yukino1230/IV-Cord-Holder-for-HIOKI-3481/README.md

# HIOKI 3481 検電器用 IV線保持ジグ

日置電機（HIOKI）の非接触検電器 **3481** に取り付けて、先端のセンサー部（ノーズ）の横に IV 線を挟んで保持するための 3D プリント用ジグです。
検電器の先端を線に下から押し当てるだけでパチッとはまるので、機器に接続されたままの IV 線にも使えます。

**MakerWorld でも公開しています：** [HIOKI 3481 検電器用 IV線ホルダー](https://makerworld.com/ja/models/3461142-hioki-3481-voltage-detector-iv-wire-holder-iv-wire)（Bambu Studio のプリントプロファイル付き）

## 対応機種

| 機種 | 状態 |
|---|---|
| HIOKI 3481（LEDライト付き） | 動作確認済み |
| HIOKI 3480（LEDライトなし） | 対応見込み（未確認）。ジグが掛かる本体・リブ・ノーズの形状は 3481 と共通です |

3480 で使ってみた方は、Issue などで結果を教えてもらえるとうれしいです。

> **非公式品です。** 日置電機株式会社とは関係ありません。
> 使用前後に必ず既知の活線で検電器の動作を確認してください。使用は自己責任でお願いします（詳しくは[注意事項・免責](#注意事項免責)）。

| 取り付けた状態（ボタン面側） | 取り付けた状態（背面側） |
|---|---|
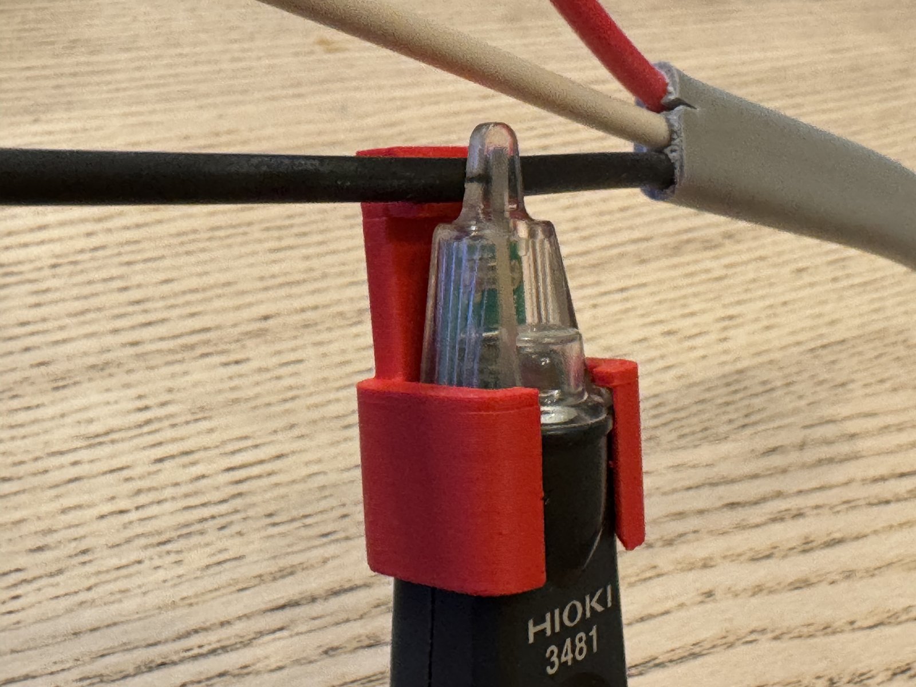
[picture p1: images/photo_in_use_front.jpg]
取り付けた状態・ボタン面側
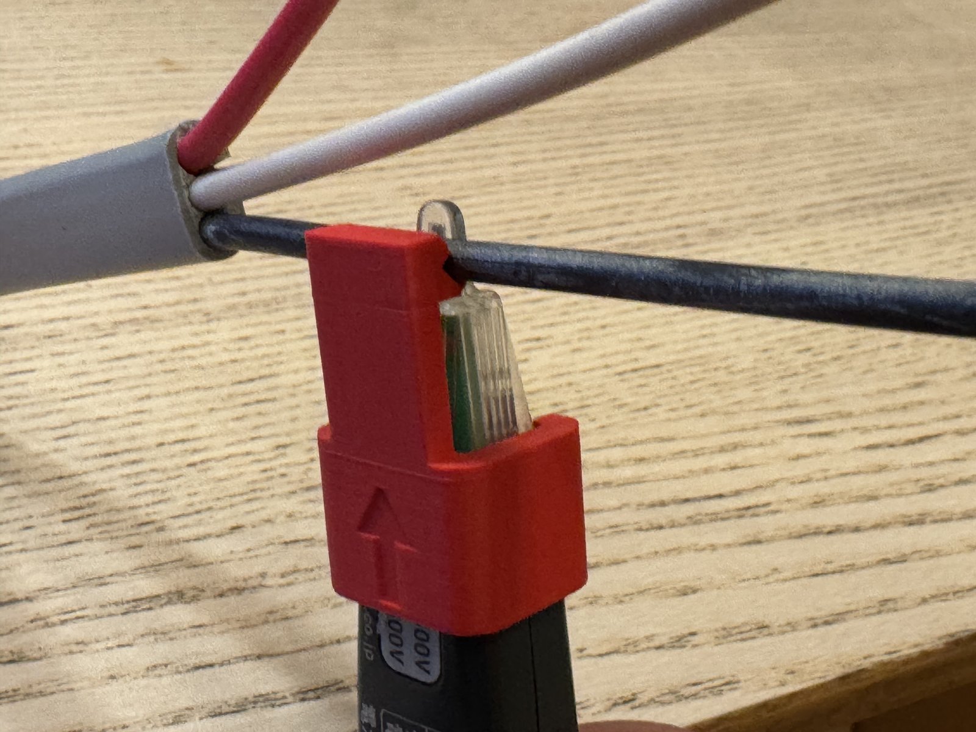
[picture p2: images/photo_in_use_back.jpg]
取り付けた状態・背面側
|  |  |

検電器に取り付けて IV 線を挟んだところ。線はノーズ（先端の平たいセンサー部）の側面に当たり、窓から ON/OFF ボタンと先端寄りの楕円部が見えます。

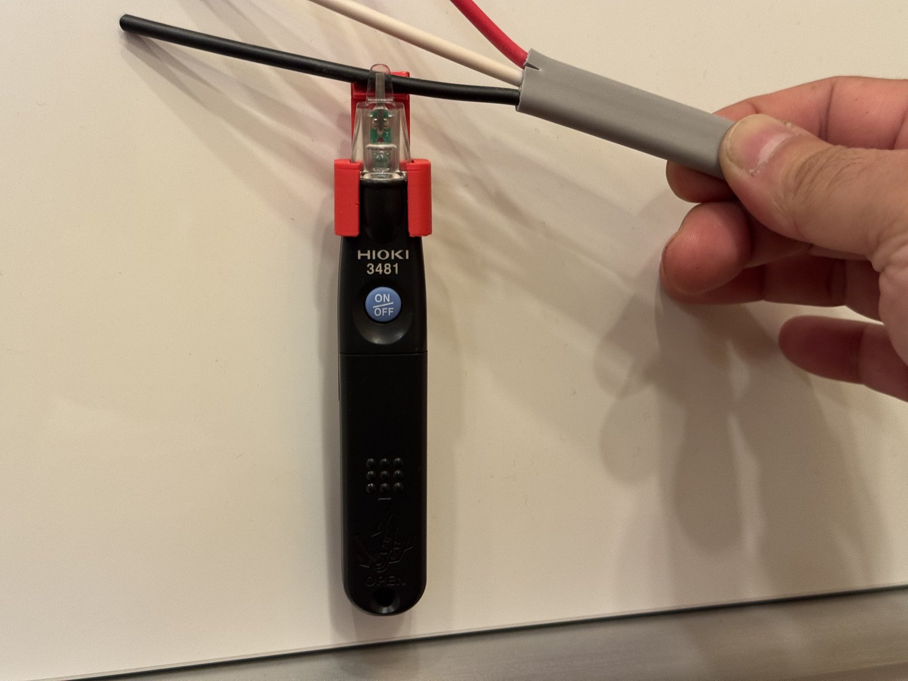
[picture p3: images/photo_hanging.jpg]
IV線にぶら下げた状態


IV 線にぶら下げた状態。一時的に手を離しても検電器ごと保持できますが、ぶら下げたまま放置しないでください。高所などで使うときは、検電器のストラップ穴に落下防止のストラップを付けてください。

| 単体（PLA で造形） | 3D モデル |
|---|---|
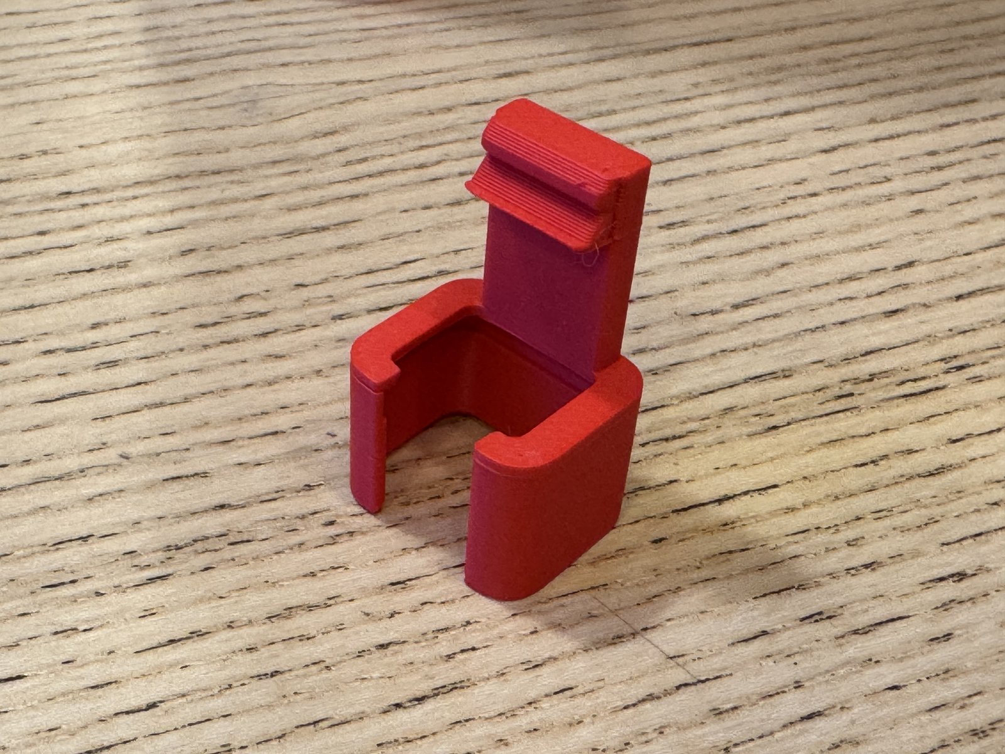
[picture p4: images/photo_printed.jpg]
実物
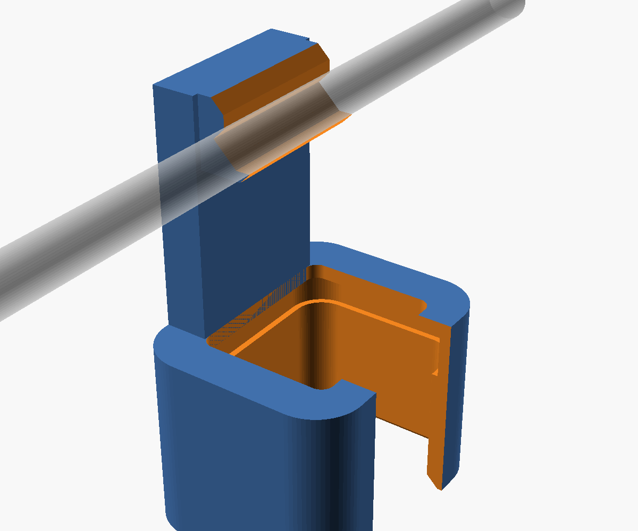
[picture p5: images/overview.png]
3Dモデル
|  |  |

## 特徴

- 検電器の先端ノーズ（平たい板状のセンサー部）の側面に、IV 線を軸と直交させて当てる
- **IV 1.6mm（外径 3.2mm）と IV 2.0mm（外径 3.4mm）の単線**に対応（V 溝で両方とも位置決め）
- 線がノーズを押す力で本体がスリーブの爪に押し付けられ、検電器と線の両方をしっかり保持
- スリーブのボタン面側は窓で開放しているので、ON/OFF ボタンと先端寄りの楕円部を覆わない
- アームの中に**結束バンドを補強材として埋め込める**ポケット付き（任意）

| IV 線の当たり方（線の方向から見た断面） | 結束バンドのポケット（アームの断面） |
|---|---|
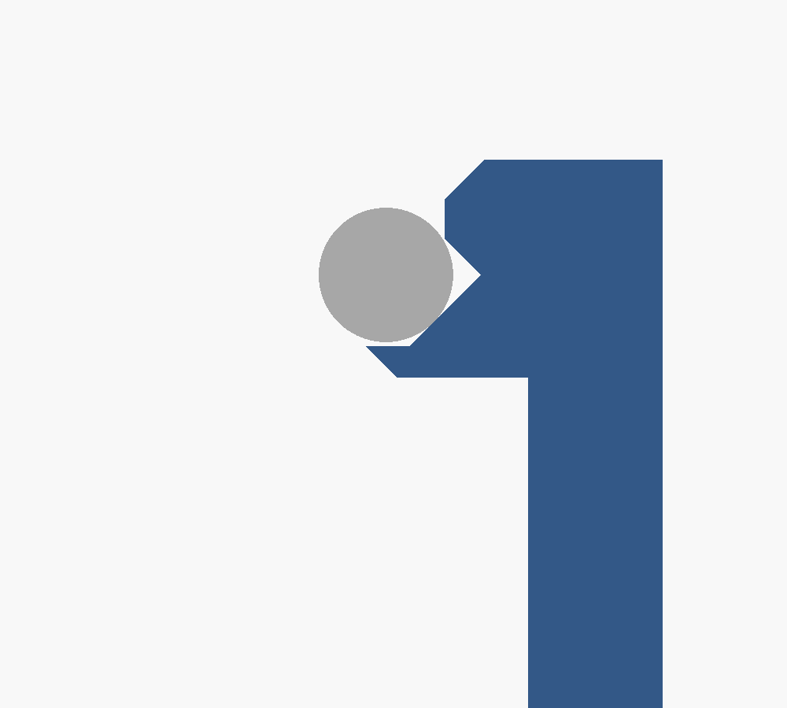
[picture p6: images/wire_contact.png]
線の当たり方
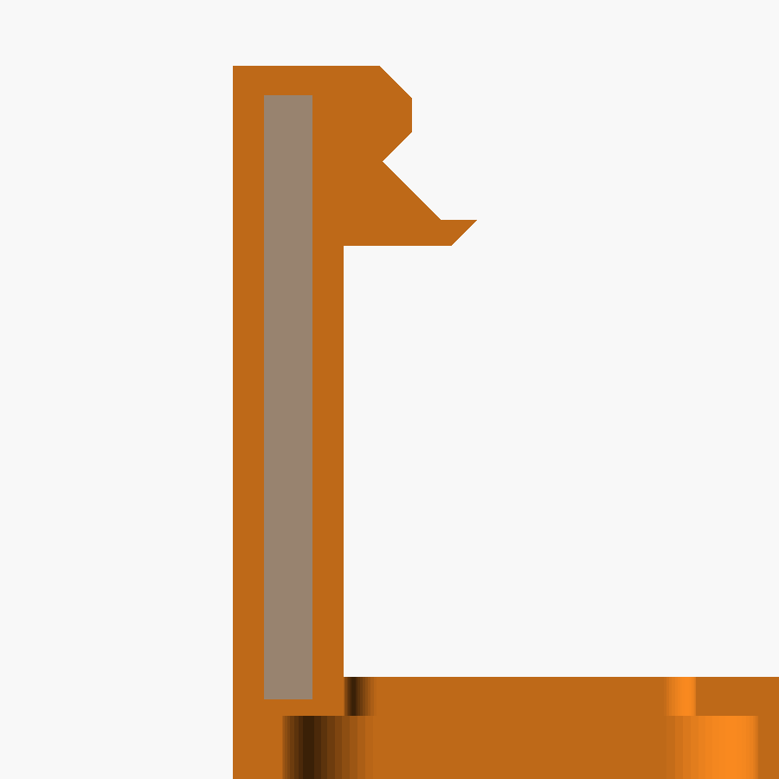
[picture p7: images/tie_pocket_section.png]
ポケット
|  |  |

## ファイル

| ファイル | 内容 |
|---|---|
| `hioki3481_iv_jig.scad` | OpenSCAD のソース（寸法はすべてパラメータで調整可） |
| `3mf/hioki3481_iv_jig_v17.2.3mf` | Bambu Studio 用のプロジェクト（ラフト・サポート・一時停止を設定済み） |
| `stl/hioki3481_iv_jig_v17.2.stl` | 結束バンドのポケット付き（おすすめ） |
| `stl/hioki3481_iv_jig_v17.2_no-tie.stl` | ポケットなし（補強材を入れない場合） |

## 印刷

- **向き：スリーブ（差し込み口）を下にして立てる。** 寝かせて刷ると、爪が開く方向の力が積層をまたぐので割れやすくなります。
- 材料：PLA で動作確認済み。PETG の場合は層間接着を優先（ノズル 240〜250℃、冷却ファン弱め）。
- 壁（ペリメーター）は 3 周以上がおすすめです。

### Bambu Studio 用の 3MF

`3mf/hioki3481_iv_jig_v17.2.3mf` には、下の「造形のポイント」の設定と、結束バンドを入れるための一時停止が入っています。

- プリンター：Bambu Lab P2S（0.4mm ノズル）、0.20mm Standard、PLA で作成
- ラフト 2 層、サポート有効（V 溝の下にサポートをペイント済み）、壁 3 周
- 一時停止：結束バンドのポケットにフタがかぶさる直前の層（ラフト込みで高さ 33.8mm の層の前）

ほかのプリンターで開く場合は、プリンターとフィラメントを自分の環境に切り替えてから、プレビューで一時停止の位置（ポケットがまだ開いている最後の層の次）を確認してください。

### 造形のポイント

- **ラフトを付ける**\
  立てて刷ると、ベッドに接するのはスリーブの細い縁だけで、背も高い（約 34mm）ため、途中で剥がれたり倒れたりしやすくなります。ラフトで接地面を広げると安定します。差し込み口の縁が潰れて広がる（エレファントフット）のも防げるので、検電器の差し込みもスムーズになります。
- **サポートを有効にし、「小さなオーバーハングを削除」はオフにする**\
  IV 線を受ける V 溝の下側（線が乗る受け面）が、アームから張り出した小さなオーバーハングになっています。「小さなオーバーハングを削除」がオンだと、ここのサポートが省かれて受け面が垂れ、線の位置や保持力が狂います。
- **結束バンドは、一時停止したらなるべく早く入れる**\
  待っている間に造形物が冷えると、再開後のフタの層がうまく接着しなかったり、ベッドから角が浮いたりします。PETG ではノズルから樹脂が垂れやすいので、再開前にノズル先端の垂れを取っておくと、フタがきれいに閉じます。

### 結束バンドの埋め込み（ポケット付きの場合）

補強材として、ヘラマンタイトン AB300（幅 4.9 × 厚 1.5mm）相当の結束バンドを使います。ナイロンなので絶縁物で、検電の感度に影響しません。

1. 結束バンドの平らな部分を **17〜18mm** に切る（ポケットの長さは約 18.7mm。長すぎなければ、短いぶんには問題なし）。
2. Bambu Studio のプレビューで、**ポケットにフタがかぶさる最初の層**に一時停止を入れる。
   レイヤースライダーの上の「+」を右クリック →「一時停止を追加」。
   モデル単体での高さは約 33.2〜33.4mm ですが、**ラフトを付けるとその厚みの分だけ高くなる**ので、高さの数字ではなく、プレビューでポケットがまだ開いている最後の層を確かめて、その次の層に入れてください。
3. 止まったらすぐに結束バンドをポケットに押し込み、上端が縁から出ていないことを確認して再開する。

ポケットの高さや切る長さは、OpenSCAD でレンダリングしたときのコンソール（ECHO）にも表示されます。

## 使い方

1. 検電器の先端を、**スリーブの後ろ（面取りしてある口）から差し込み**、先端のツバに当たるまで押し込む。
   背中の矢印が差し込む向きです。
   **ボタン面側から横に押し込むと爪が割れます。**
2. 検電器の先端を上に向け、IV 線に下から押し当てて、ノーズの横の V 溝にはめる（爪を越えてパチッと入る）。
3. 検電する。
4. 外すときは、検電器を下へ引いて線を V 溝から外してから、検電器をスリーブの後ろへ抜く。

| 差し込み口（スリーブの後ろ） | 背面の矢印（差し込む向き） | 取り付けた状態 |
|---|---|---|
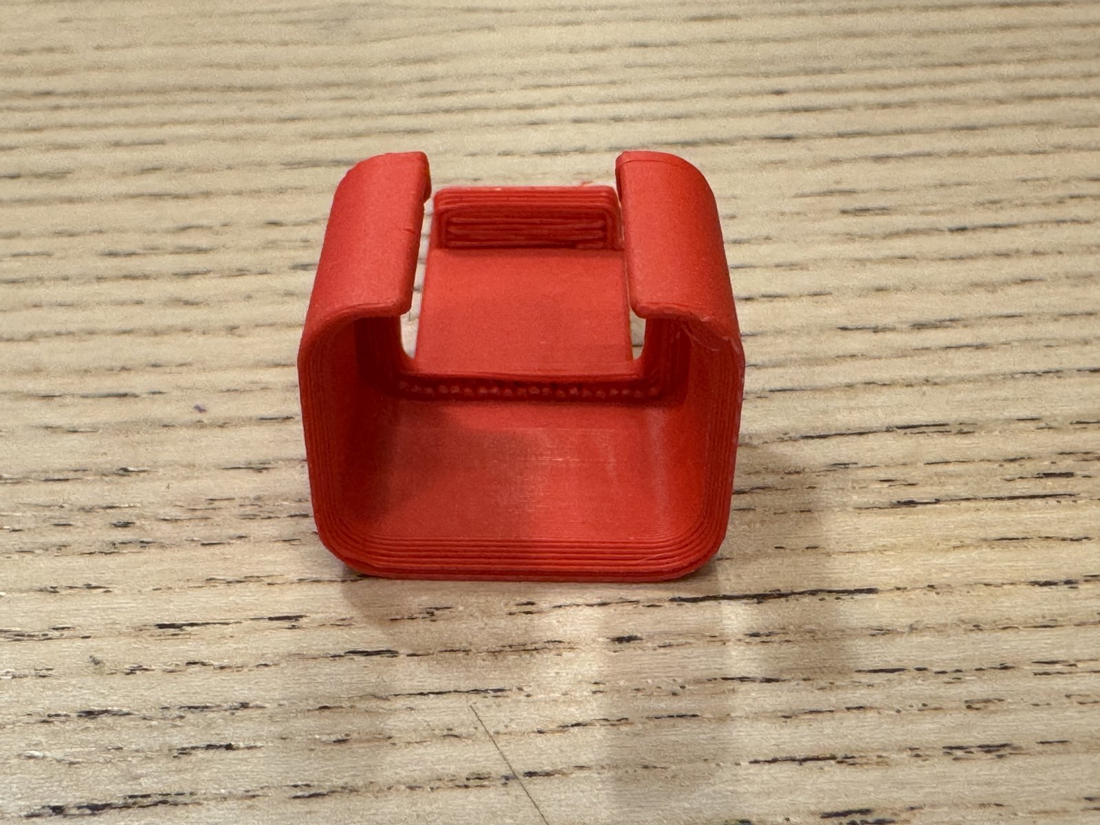
[picture p8: images/photo_rear_opening.jpg]
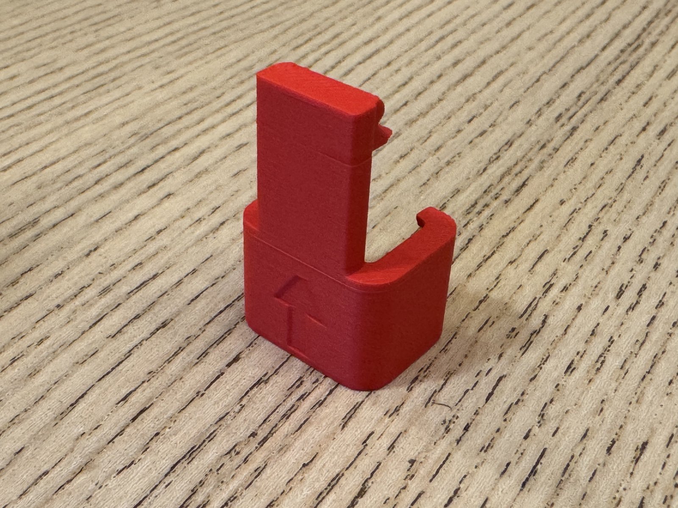
[picture p9: images/photo_printed_back.jpg]
背面の矢印
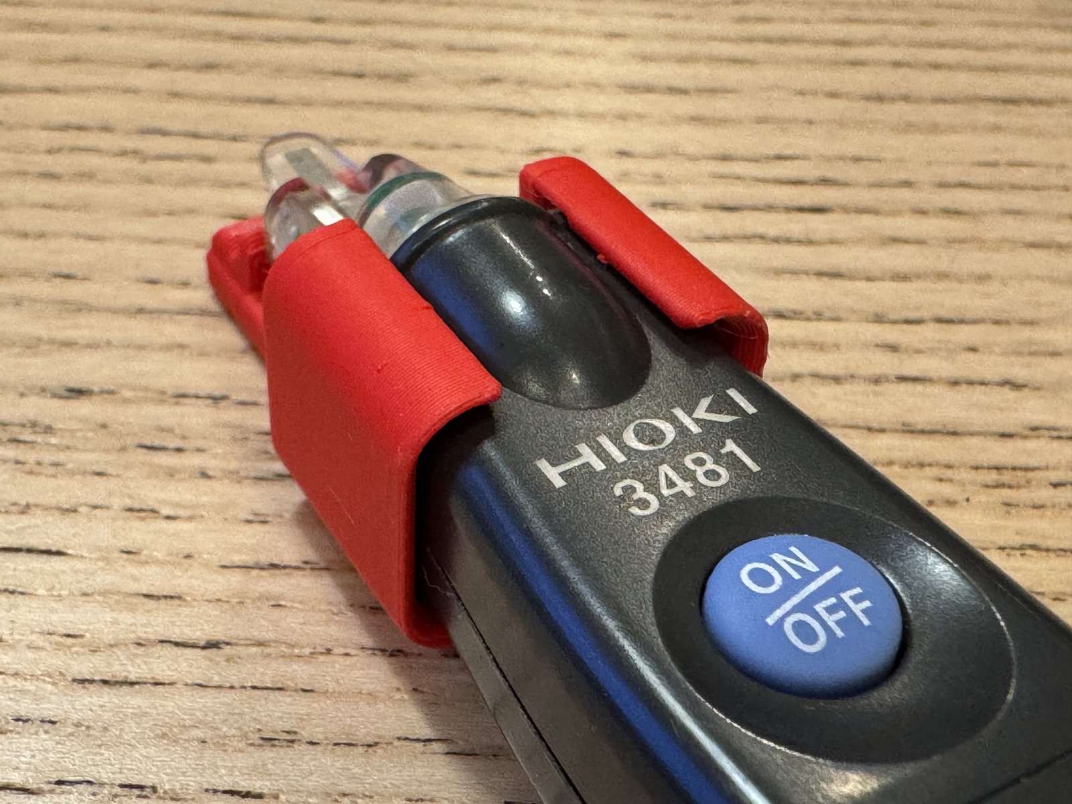
[picture p10: images/photo_attached.jpg]
取り付けた状態
|  |  |  |

取り付けると、窓から ON/OFF ボタンと先端寄りの楕円部が見えたままになり、ボタンもそのまま押せます。

<details>
<summary>3D モデルの図（差し込み口・背面の矢印）</summary>

| 差し込み口（3D モデル） | 背面の矢印（3D モデル） |
|---|---|
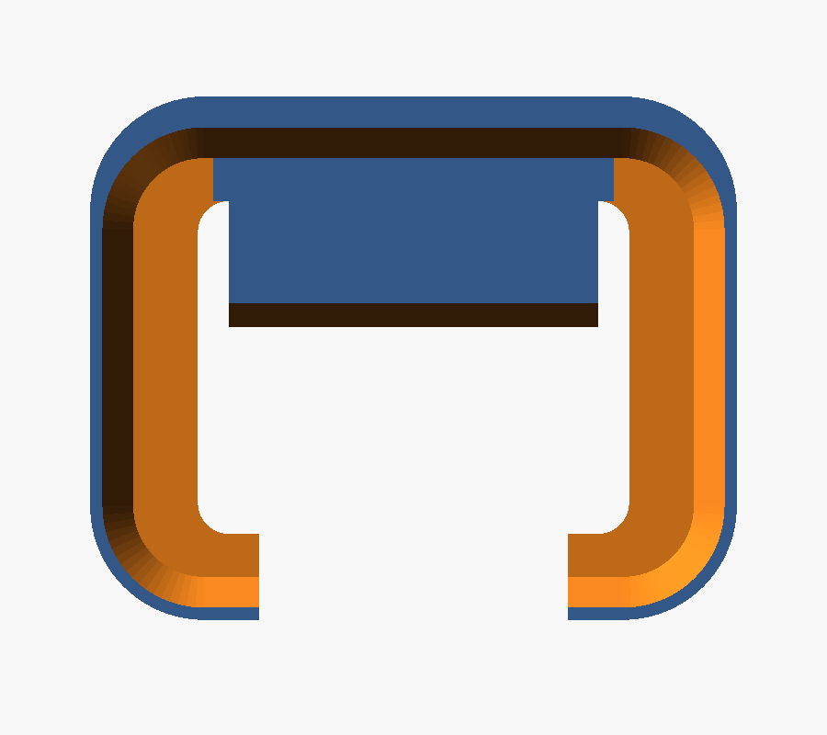
[picture p11: images/rear_opening.png]
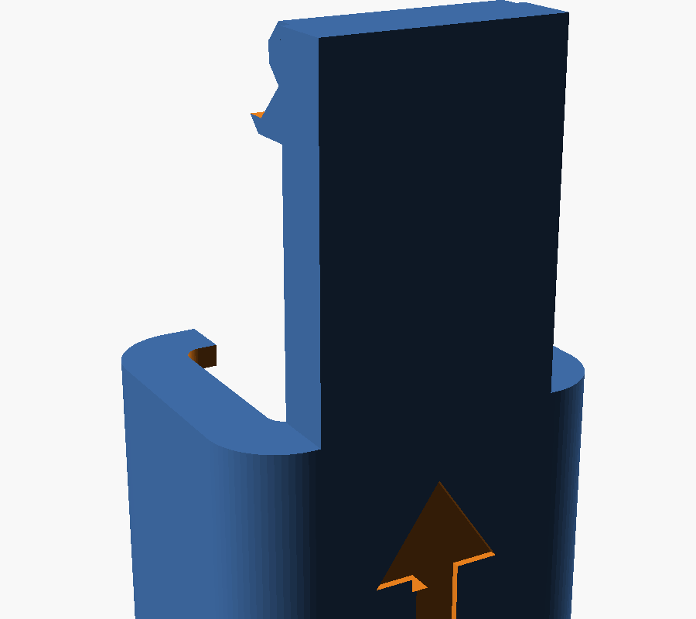
[picture p12: images/back_arrow.png]
矢印
|  |  |

</details>

## 調整できる主なパラメータ

| パラメータ | 初期値 | 内容 |
|---|---|---|
| `clr_d` | 0.3 | 厚み方向の片側すき間。増やすと V 溝も同じだけ自動でずれ、線の押し付け量は変わらない |
| `w_extra` | 0.6 | 幅方向に追加する余裕（合計） |
| `squeeze` | 0.15 | IV 1.6mm をノーズへ押し付ける量（IV 2.0mm はこれ + 約 0.25mm） |
| `open_gap` | 2.8 | V 溝の入口の幅。線を押し込むのが固ければ 3.0 前後に |
| `use_rib` | true | false で結束バンドのポケットなし |
| `tie_w` / `tie_t` | 4.9 / 1.5 | 結束バンドの幅・厚み |
| `tie_clr` | 0.03 | ポケットの片側すき間。入らなければ 0.05〜0.08 に |
| `rib_ch` | 1.0 | リブ受け溝の後ろ側の段差を斜めにする長さ。外すのが硬ければ増やす（0 で段差のまま） |
| `contact_h` | 5.0 | ノーズ頂点から IV 線の中心までの距離（当てる高さ） |

本体寸法は実機の実測値と、日置電機が公開している外形図（3481A040）を参考にしています。外形図そのものはこのリポジトリには含めていません。

## 注意事項・免責

- 本品は個人が製作した非公式のデータです。日置電機株式会社とは関係ありません。
- 保持力は、使用するプリンター・材料・印刷設定・線の状態によって変わります。使用前に、保持力と検電器の動作を必ず確認してください。
- 線にぶら下げたまま放置しないでください。高所や、落下すると物を傷つけるおそれのある場所では、検電器のストラップ穴に落下防止のストラップを付けて使用してください。
- 爪やアームにヒビ・白化が見られたら使用をやめてください。
- 本データの使用によって生じた検電器の落下・破損、建物や設備の損傷、事故その他いかなる損害についても、作者は責任を負いません。すべて使用者の責任でご利用ください。

## バージョン

現在の版：**v17.2**　変更履歴は [CHANGELOG.md](CHANGELOG.md) を参照。

## ライセンス

[CC BY-NC 4.0](https://creativecommons.org/licenses/by-nc/4.0/deed.ja)（表示 - 非営利）。詳しくは [LICENSE](LICENSE) を参照。
改変・再配布は自由ですが、作者の表示が必要で、営利目的での利用（販売など）はできません。

---

### English summary

A 3D-printable jig for the HIOKI 3481 non-contact voltage detector (the 3480 shares the same body shape and should also fit, but is untested) that holds a solid IV wire (1.6 mm / 2.0 mm) against the side of the detector's sensor tip. Print standing (sleeve opening down). Optional pocket for a nylon cable tie (4.9 × 1.5 mm) as an insulating stiffener, inserted during a print pause. Insert the detector from the rear of the sleeve only. Unofficial; not affiliated with HIOKI E.E. Corporation. Always verify the detector on a known live circuit before and after use. Do not leave the detector hanging on the wire unattended; use a lanyard on the detector's strap hole when working at height. Provided as-is without warranty; the author accepts no liability for any damage, including a dropped or damaged detector or damage to buildings or equipment. Use at your own risk. Licensed under CC BY-NC 4.0. Also on MakerWorld: https://makerworld.com/ja/models/3461142-hioki-3481-voltage-detector-iv-wire-holder-iv-wire
