yukino1230/IV-Cord-Holder-for-HIOKI-3481/3mf/hioki3481_iv_jig_v17.2.3mf

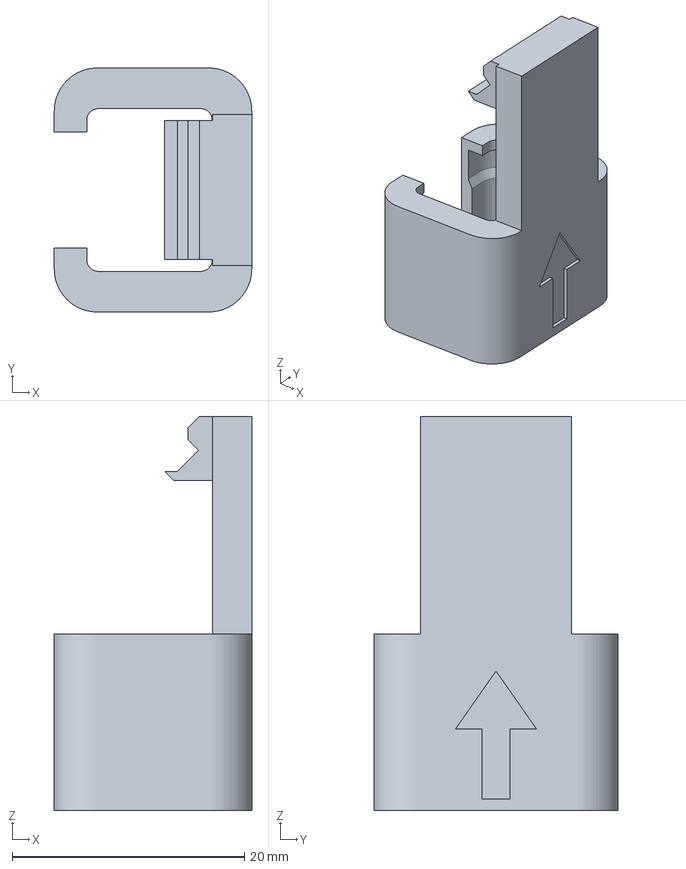
[picture p13: CAD file, 2026-10-11]
3mf/hioki3481_iv_jig_v17.2.3mf
17.0 x 21.0 x 33.9 mm
