yukino1230/IV-Cord-Holder-for-HIOKI-3481/stl/hioki3481_iv_jig_v17.2_no-tie.stl

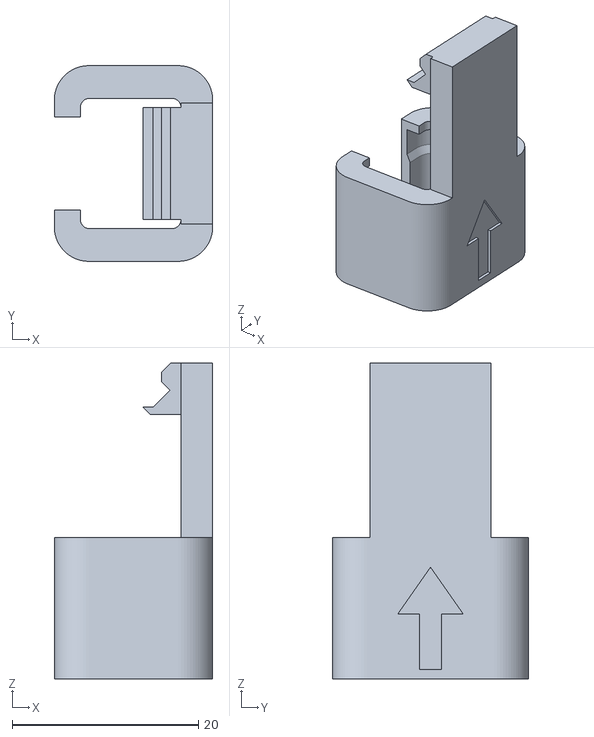
[picture p14: CAD file, 2026-10-11]
stl/hioki3481_iv_jig_v17.2_no-tie.stl
17.0 x 21.0 x 33.9
