yukino1230/IV-Cord-Holder-for-HIOKI-3481/stl/hioki3481_iv_jig_v17.1.stl

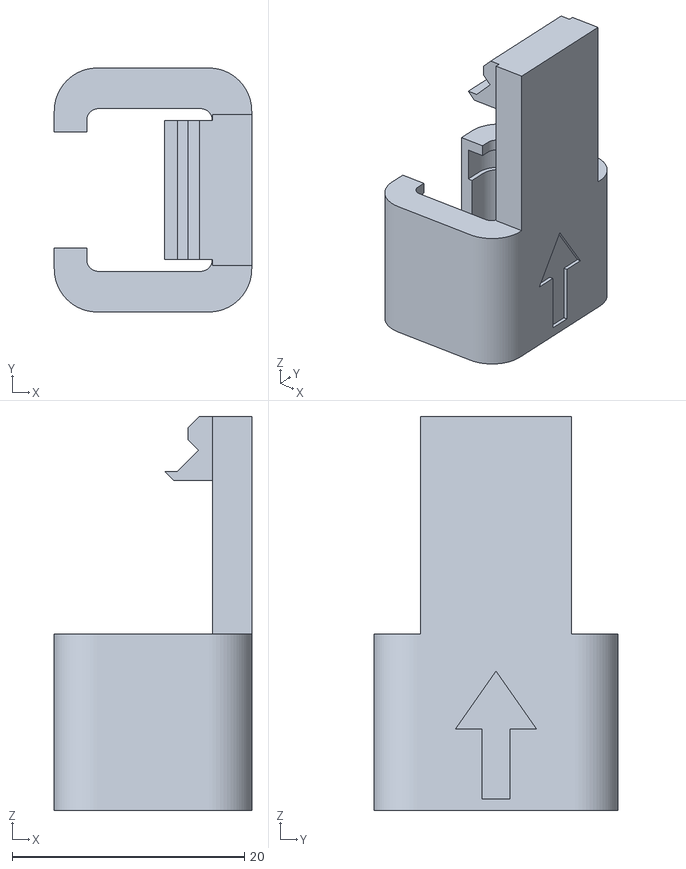
[picture p15: CAD file, 2026-10-11, an earlier design]
stl/hioki3481_iv_jig_v17.1.stl
17.0 x 21.0 x 33.9
