yukino1230/IV-Cord-Holder-for-HIOKI-3481/(list of files, cad)

Other CAD files:
stl/hioki3481_iv_jig_v17.2.stl
