yukino1230/IV-Cord-Holder-for-HIOKI-3481/CHANGELOG.md

# 変更履歴

試作と現物合わせで形を詰めてきた経緯です。

## v17.2
- リブ受け溝の後ろ側の直角の段差を、1.0mm かけて斜めにした（`rib_ch`）。検電器を外すときにリブが乗り上げやすくなり、外すのが楽になった。
- 線をはめていない状態では前後に少しカタつくが、線をはめると押し付け力で固定されるので実用上は問題なし。
- Bambu Studio 用の 3MF（ラフト・サポート・一時停止を設定済み）を追加。

## v17.1
- 結束バンドのポケットの片側すき間を 0.15mm → 0.03mm に詰めた（0.15mm ではスカスカだった）。

## v17
- アームの中に結束バンド（4.9 × 1.5mm）を埋め込むポケットを追加。印刷中に一時停止して差し込む。
- ナイロンは絶縁物なので、線のすぐ近くまで通しても検電の感度に影響しない。金属やカーボンの補強材は使わない。

## v16
- 保持方式を v13 に戻した（窓幅 10mm、爪が本体ボタン面に片側 4.1mm 掛かる）。
  線がノーズを押す力で本体が爪に押し付けられ、その摩擦で検電器と線を保持する。
- v15 の補強（背中の肉厚 2.0mm、アーム厚 3.4mm、両側のリブ受け溝）は残した。
- 背中に差し込む向きの矢印を彫り、後端の差し込み口を面取り（横から押し込む誤った付け方を防ぐ）。
- 厚み方向のすき間 `clr_d` を追加。増やすと V 溝も連動してずれる。
- 印刷の向きは「立てる」が正解（寝かせると PLA で爪が一発で割れた）。

## v15（不採用）
- 外形図をもとに V 溝の位置を計算し直したが、保持の要だった押し付け力がなくなり、ブカブカになって線も保持できなかった。

## v14（不採用・v15 に統合）
- ボタン面側から横にパチッと付けられる形にした（爪は本体の角に 0.8mm 掛かるだけ）。この形が v15 の保持力不足の一因になった。

## v12〜v13
- アームを内側へ寄せ、背中をスリーブと面一にした。スリーブの肉厚を 1.4mm に。
- 立てて刷るとアームの根元が折れた（このときはアーム厚 2.4mm、根元の肉厚 0.9mm）。
- 現場で、横から押し込もうとしてクリップ部が割れた。

## v9〜v11
- 本体先端のリブ（幅 18mm）を収める受け溝を追加。溝の長さを 2.0 → 3.5mm に。
- スリーブの幅方向に余裕（+0.6mm）を追加。本体は後ろへいくほど太くなる。

## v6〜v8
- V 溝で IV 1.6mm と 2.0mm の両方に対応。
- 線を当てる位置と高さを現物合わせで調整（ノーズは扁平なので中心寄りに）。

## v1〜v5
- 先端に IV 線を当てる案から始まり、機器に接続したままの線を挟めるよう片持ちのアームに変更。
- 線はノーズの頂点ではなく側面に当てる必要があることがわかり、側面に当てる形に変更。
