yukino1230/IV-Cord-Holder-for-HIOKI-3481/(commit log)

2026-10-11 v17.1 初回公開
    [hioki3481_iv_jig.scad, hioki3481_iv_jig_v17.1.stl, hioki3481_iv_jig_v17.1_no-tie.stl]
2026-10-11 実物の写真（正面・背面）を追加
2026-10-11 取り付け状態とぶら下げ状態の写真を追加
2026-10-11 対応機種に3480（見込み）を追記
2026-10-11 取り付け状態と差し込み口の写真を追加
2026-10-11 造形のポイントを追記
2026-10-11 線のはめ方の説明を修正（下から押し当てる）
    [hioki3481_iv_jig.scad]
2026-10-11 v17.2：リブ受け溝の段差を面取り、3MFを追加
    [hioki3481_iv_jig.scad, hioki3481_iv_jig_v17.1_no-tie.stl, hioki3481_iv_jig_v17.2.3mf, hioki3481_iv_jig_v17.2.stl, hioki3481_iv_jig_v17.2_no-tie.stl]
2026-10-19 注意事項・免責とMakerWorldのリンクを追加
